jaimechu/cmumechatronics2016teamb/documents/TeamB_QuadChart.pptx

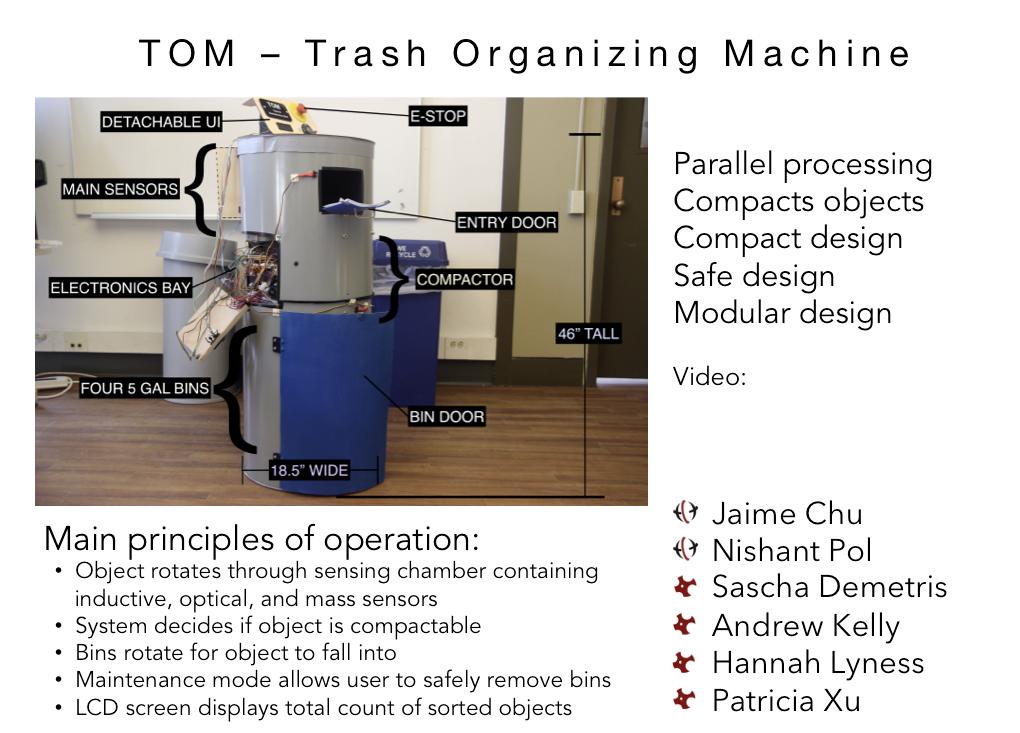
[picture p10: figure]

https://youtu.be/ (https://youtu.be/ZPbSDOQ6ui4)ZPbSDOQ6ui4 (https://youtu.be/ZPbSDOQ6ui4)

16-778/18-578/24-778 Mechatronic Design

Spring 2016
