jaimechu/cmumechatronics2016teamb/about/andrew.png

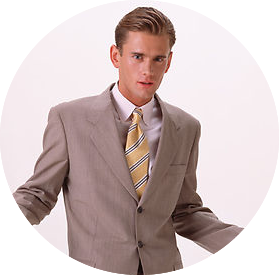
about/andrew.png
