jaimechu/cmumechatronics2016teamb/about/nishant.png

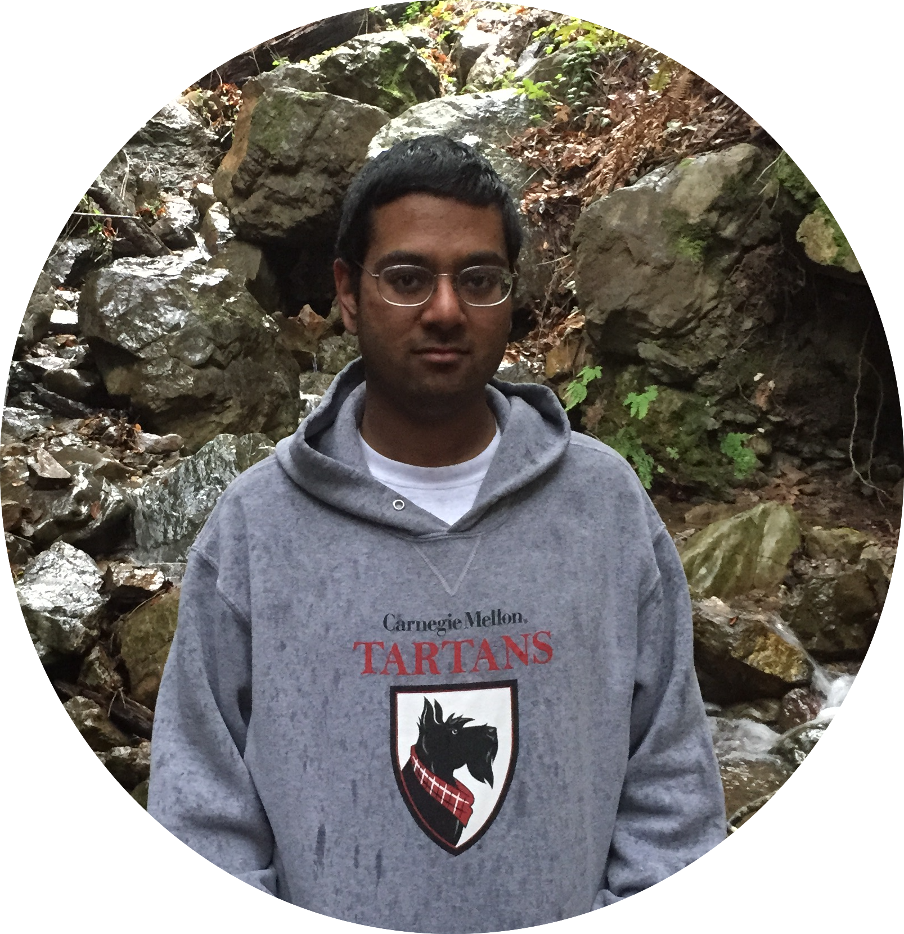
about/nishant.png
