jaimechu/cmumechatronics2016teamb/about/patricia.png

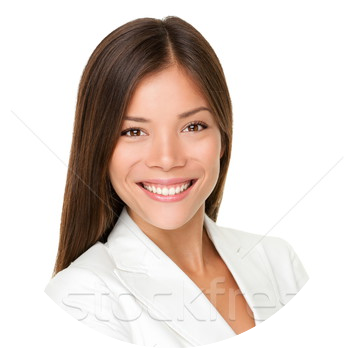
about/patricia.png
