jaimechu/cmumechatronics2016teamb/about/sascha.png

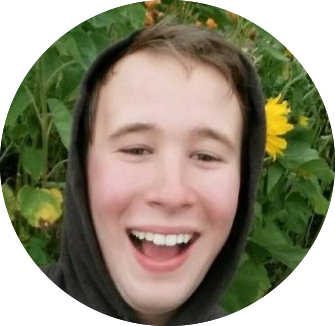
about/sascha.png
