jaimechu/cmumechatronics2016teamb/implementation/bins.jpg

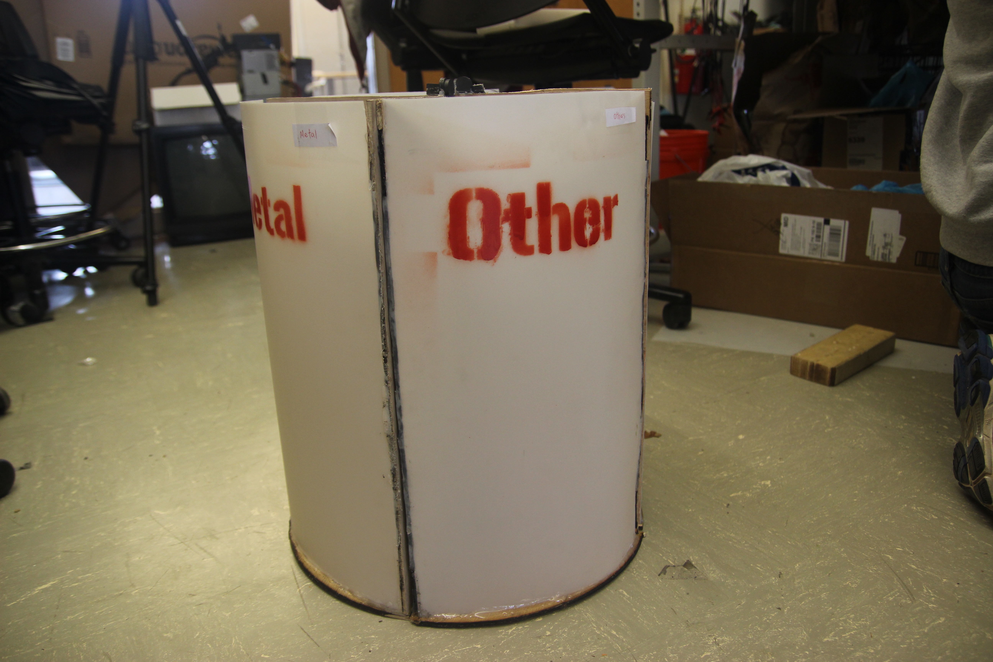
implementation/bins.jpg
