jaimechu/cmumechatronics2016teamb/implementation/chimney.jpg

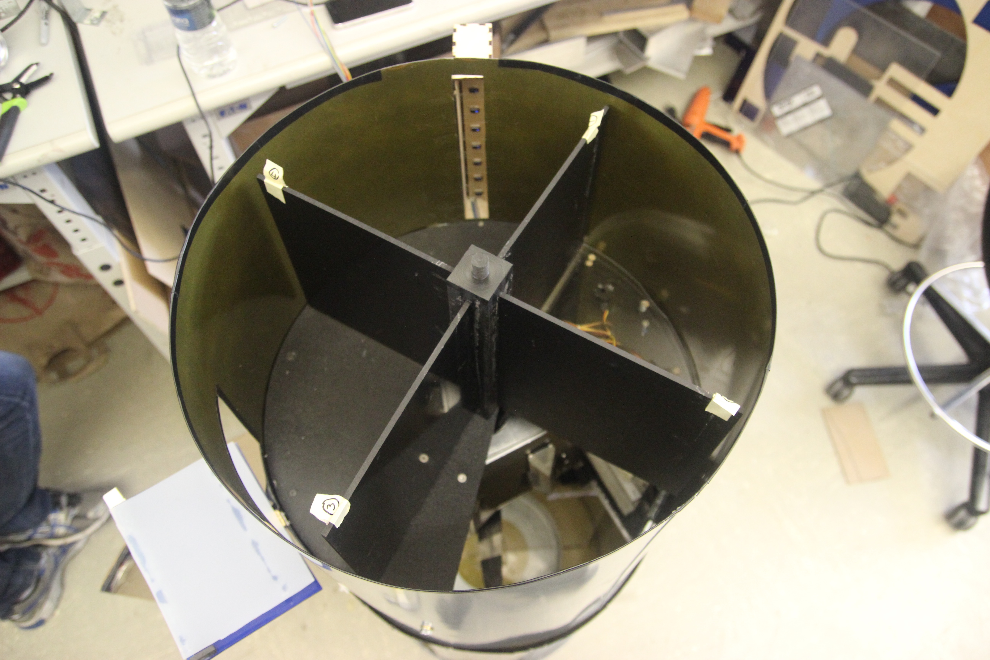
implementation/chimney.jpg
