jaimechu/cmumechatronics2016teamb/implementation/compact.png

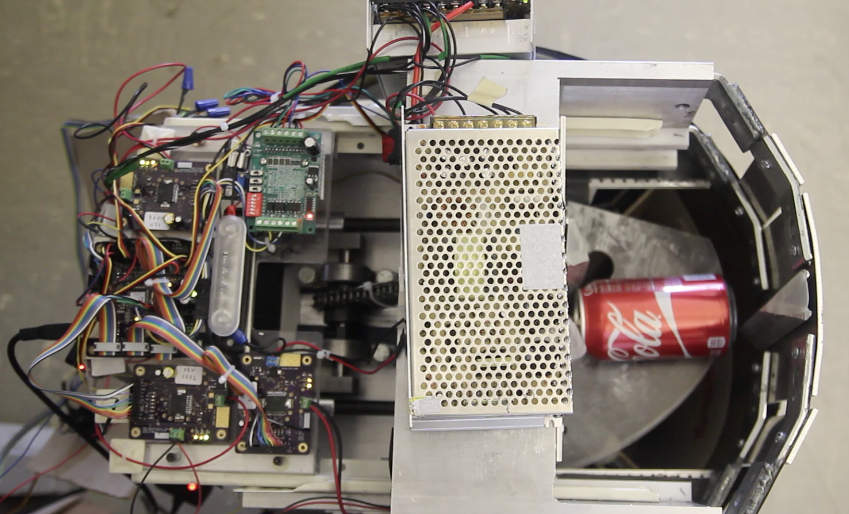
implementation/compact.png
