jaimechu/cmumechatronics2016teamb/implementation/inductance.png

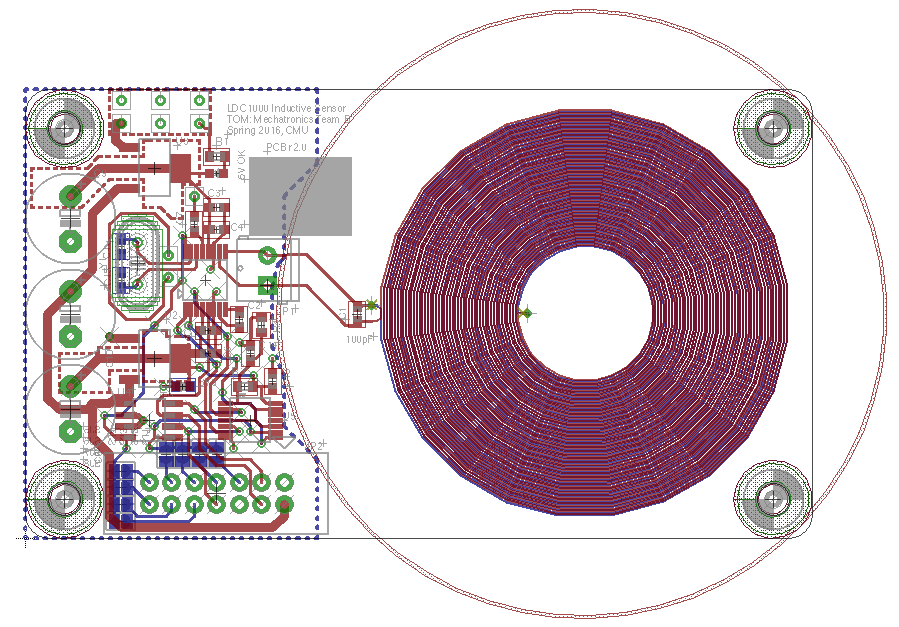
implementation/inductance.png
