jaimechu/cmumechatronics2016teamb/implementation/optical.jpg

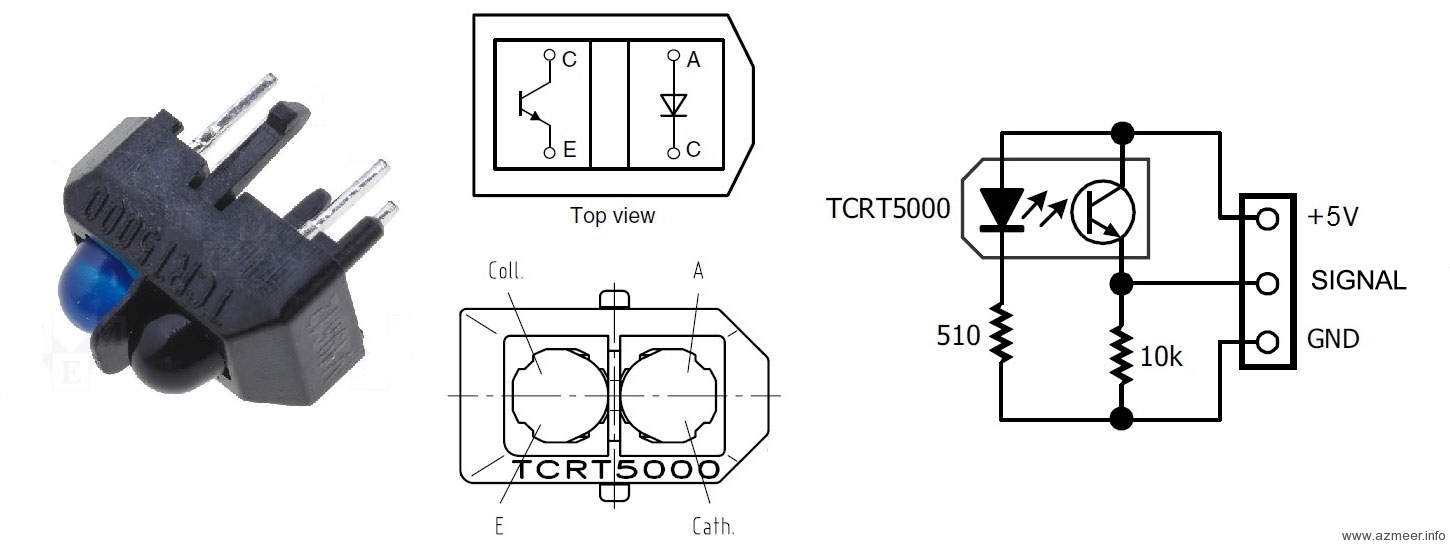
implementation/optical.jpg
