jaimechu/cmumechatronics2016teamb/implementation/ui.jpg

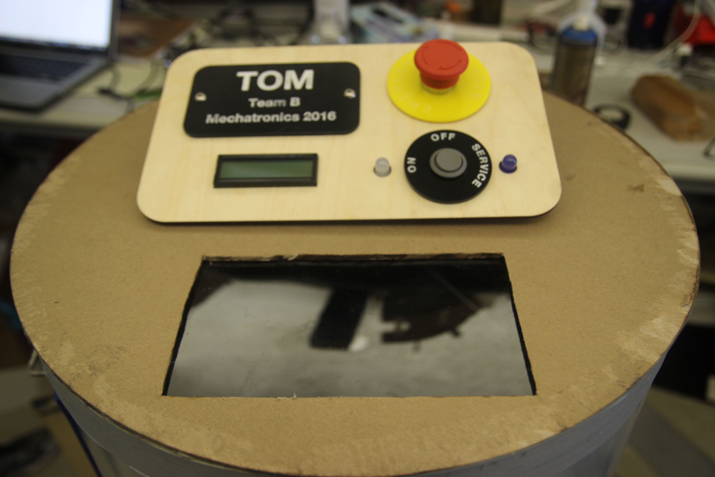
implementation/ui.jpg
