jaimechu/cmumechatronics2016teamb/(threads)

Thread 1 (2016-03-31):

Main Controller FW: ADC sequence 2 only running once

npol, 2016-03-31:
sequence 2 only completes one conversion

npol, 2016-03-31:
ADC12SC bit needs to be cleared before it is set to start new conversion

npol, 2016-03-31:
Code fixed

Closed 2016-03-31.
